adnovea/ETX-LINK-506/Meade #506 CCS EMULATION.md

## #506 CCS Emulation

I initially assumed that emulating the Meade DATA/CLK pseudo-I2C bus at 1.5 kHz using a 240 MHz ESP32 would be straightforward. 

However, I was totally wrong. I develop pieces of software but I'm not a software engineer and completely fail to handle a Real-Time task on an ESP32. While several approaches worked in standalone test benches, they consistently failed once integrated into the main application due to interference from concurrent background tasks.

The primary issue is a bus desynchronization that occurs after a few tens of seconds. This desynchronization causes the Autostar controller to detect bus corruption, resulting in a ~5-second communication pause. Additionally, observations suggest that the original #506 CCS module itself exhibits timing instabilities under certain conditions.

## Tested Approaches

* **Bit-Banging**: Works reliably in standalone mode, but fails as soon as the CPU handles additional application code.
* **Pseudo-I2C Bus**: Attempted using the standard `Wire.h` library with callbacks, but failed due to the proprietary specificities of the Meade bus protocol.
* **Dedicated Core**: Assigning the timing-critical task to a dedicated ESP32 core resulted in continuous watchdog resets and boot loops.
* **Level 3 Interrupts (with `IRAM_ATTR`)**: Allowed the bus to run for a few tens of seconds before inevitably triggering a desynchronization.
* **Level 4/5 Interrupts (with Assembly code)**: Attempted to handle bus Read/Write operations via low-level Assembly code, but could not achieve a stable implementation.
* **RMT (Remote Control)**: Explored to offload timing generation, but the approach was unsuccessful.
* **SPI**: Requires multiplexing the MOSI and MISO lines, which presents hardware risks without advanced impedance and directional control.

## Documentation & Contribution

I wrote a short breakdown of the Meade bus protocol, derived from raw datagram analysis, is available in `docs/MEADE PROTOCOL.txt`. 

If you have experimented with this bus or have insights into stable hardware/software alternatives, please feel free to share your findings. The goal is to provide a reliable hardware alternative for those who can no longer buy a #506 CCS module since Meade has gone out of business.
