adnovea/ETX-LINK-506/docs/Block diagram.png

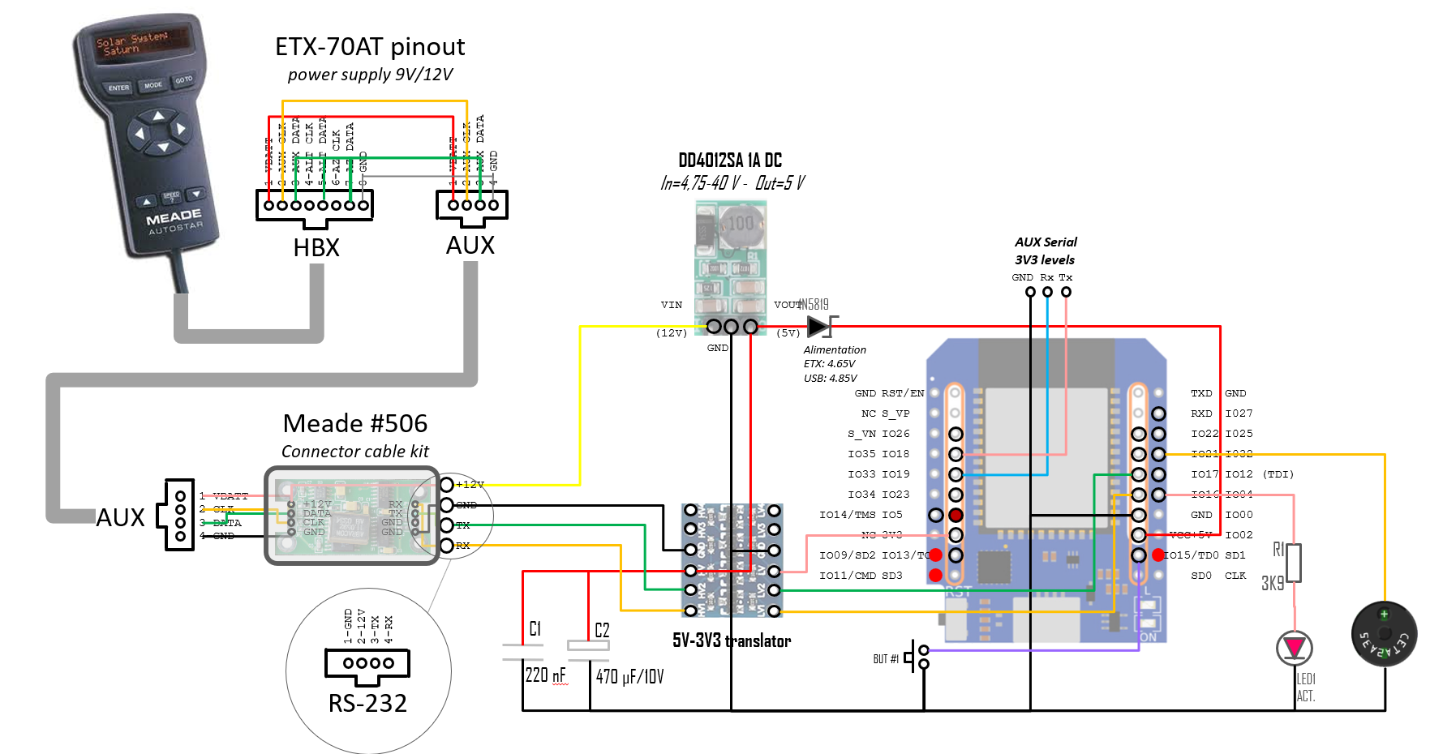
docs/Block diagram.png
