adnovea/ETX-LINK-506/docs/Circuit.webp

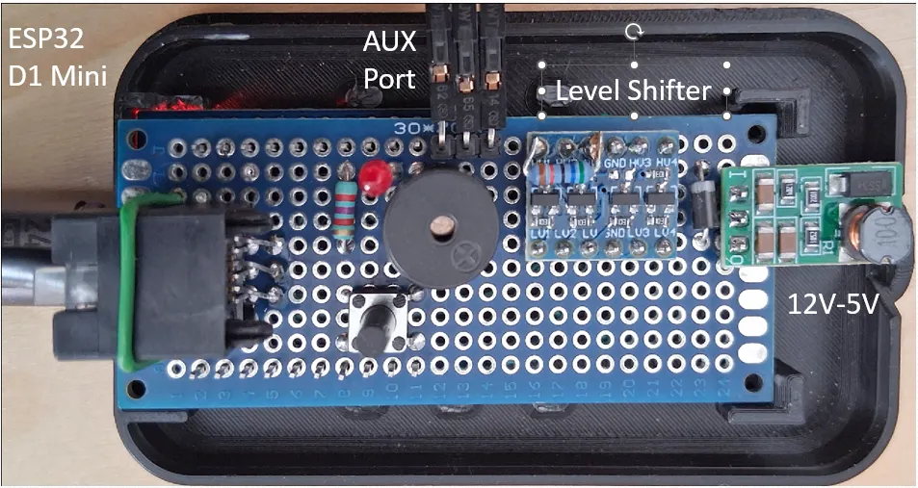
docs/Circuit.webp
